neura-neura/v102-led-batten-mount/cad/v102-mount.step

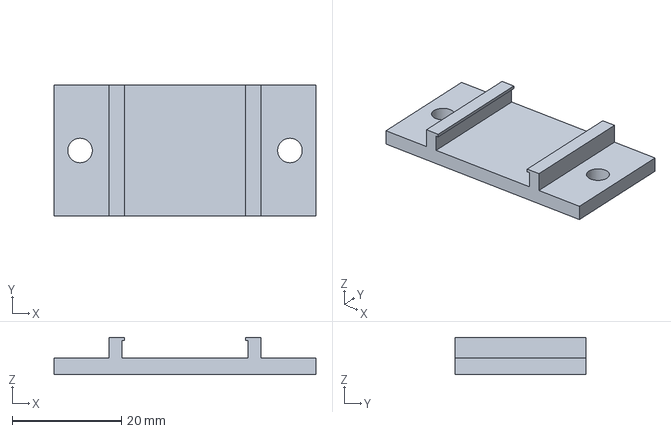
[picture p5: CAD file, 2026-10-24]
cad/v102-mount.step
48.0 x 24.0 x 6.80 mm
