neura-neura/v102-led-batten-mount/stl/experimental/axial-stop-untested.stl

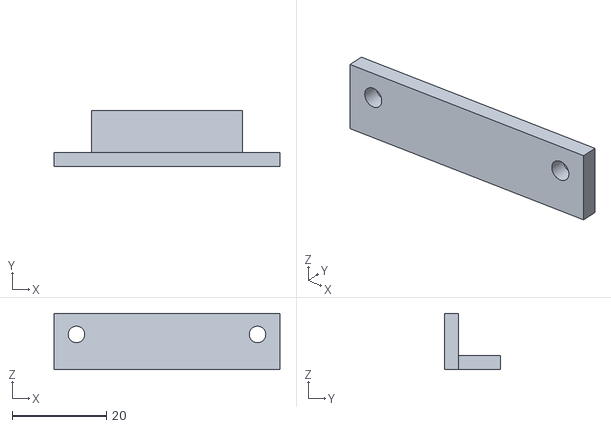
[picture p6: CAD file, 2026-10-24]
stl/experimental/axial-stop-untested.stl
48.0 x 12.0 x 12.0
