neura-neura/v102-led-batten-mount/(list of files, cad)

Other CAD files:
stl/v102-mount-r02-confirmed-fit.stl
stl/v102-mount-r02-regenerated.stl
stl/archive/v102-mount-r01-entry-0.4mm-untested.stl
stl/archive/v102-mount-r01-entry-0.3mm-untested.stl
stl/archive/v102-mount-r01-entry-0.2mm-loose-fit.stl
cad/v102-mount.FCStd
